VladaNedelceva/TSC---project/Hardware/Schematic.sch

## EAGLE design Hardware/Schematic.sch (2026-04-19)

Schematic: Schematic.sch

Parts:
ANT1: 2450AT18B100E_2450AT18B100E; 2450AT18B100E_ANTC3216X140N
C1, C26: 12pF; ESP32_C6_LIBRARY_1_ESP32_WROVER_EAGLE-LTSPICE_C0402
C1-EP-DR: 10uF; ESP32_C6_LIBRARY_1_ESP32_WROVER_EAGLE-LTSPICE_C0402
C2-EP-DR: 4.7uF/25V; ESP32_C6_LIBRARY_1_ESP32_WROVER_EAGLE-LTSPICE_C0402
C3, C4: 1pF; ESP32_C6_LIBRARY_1_ESP32_WROVER_EAGLE-LTSPICE_C0402
C5, C7, C8: 100nF; ESP32_C6_LIBRARY_1_ESP32_WROVER_EAGLE-LTSPICE_C0402
C6, C14: 4.7µF; ESP32_C6_LIBRARY_1_ESP32_WROVER_EAGLE-LTSPICE_C0402
C9: 820pF; ESP32_C6_LIBRARY_1_ESP32_WROVER_EAGLE-LTSPICE_C0402
C10, C22: N.C.; ESP32_C6_LIBRARY_1_ESP32_WROVER_EAGLE-LTSPICE_C0402
C11: 100pF; ESP32_C6_LIBRARY_1_ESP32_WROVER_EAGLE-LTSPICE_C0402
C12, C19: 100nF; PERFECT_0402_0402
C13: N.C.; PERFECT_0402_0402
C15: 1.0µF; PERFECT_0402_0402
C16: 47nF; PERFECT_0402_0402
C17, C18: 12pF; PERFECT_0402_0402
C20, C21: 4.7µF; PERFECT_0402_0402
C23: 0.1uF; ESP32_C6_LIBRARY_1_ESP32_WROVER_EAGLE-LTSPICE_C0402
C24: 10uF; GRM011R60J152KE01L_2_CAPC0201X13N
C25, C33: 22uF; ESP32_C6_LIBRARY_1_ESP32_WROVER_EAGLE-LTSPICE_C0402
C27, C34, C42: 0.1uF; GRM011R60J152KE01L_2_CAPC0201X13N
C29, C30, C31, C32: 1uF; GRM011R60J152KE01L_2_CAPC0201X13N
C37, C38: 1uF; GRM011R60J152KE01L_1_0201
C39: 10uF; PERFECT_0402_0402
C43: 4.7uF; ESP32_C6_LIBRARY_1_ESP32_WROVER_EAGLE-LTSPICE_C0402
D2, D4, D5: MBR0530; ESP32_C6_LIBRARY_5_SOD3716X135N
D3: USBLC6-2SC6Y; ESP32_C6_LIBRARY_3_SOT95P280X145-6N
EPD_C1, EPD_C2, EPD_C6, EPD_C7, EPD_C8, EPD_C9, EPD_C10, EPD_C11, EPD_C12: 1uF/50V; ESP32_C6_LIBRARY_1_ESP32_WROVER_EAGLE-LTSPICE_C0402
EPD_C5: 0.1uF/50V; ESP32_C6_LIBRARY_1_ESP32_WROVER_EAGLE-LTSPICE_C0402
IC1: BQ25180YBGR_BQ25180YBGR; BQ25180YBGR_BGA8C40P2X4_100X155X50
IC2: RT6160AWSC_RT6160AWSC; RT6160AWSC_BGA15C40P3X5_140X230X60
IC3: BMA421_BMA421
IC4: DRV2605YZFR_DRV2605YZFR; DRV2605YZFR_BGA9C50P3X3_144X144X62
J1: TC2030-IDC_TC2030-IDC; TC2030-IDC_TC2030IDC
J2: 503480-2400; 503480-2400_5034802400
J4: KH-TYPE-C-16P; KH-TYPE-C-16P_KINGHELM_KH-TYPE-C-16P
L1: 3.9nH; MLP2016SR47MT0S1_INDC2016X100N
L2: 10µH; MLP2016SR47MT0S1_INDC2016X100N
L3: 15nH; MLP2016SR47MT0S1_INDC2016X100N
L5: 68uH; MLP2016SR47MT0S1_INDC2016X100N
L7: MLP2016SR47MT0S1_FTC252012SR47MBCA; MLP2016SR47MT0S1_INDC2016X100N
Q1: 20V/4.2A/52mΩ/1.4W; ESP32_C6_LIBRARY_4_ESP32_C6_LIBRARY_4_ESP32_C6_LIBRARY_4_ES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
Q3: SI1308EDL-T1-GE3; ESP32_C6_LIBRARY_6_SOT65P210X110-3N
R1_EP_DR: 0.47; CPF0201D7K68C1_0201
R1_USB, R2_USB: 5K1; ERA-1AEB3401C_0201
R2, R3, R4: 0; CPF0201D7K68C1_0201
R2_EP_DR, R9: 10K; CPF0201D7K68C1_0201
R5, R7, R8: 10k; CPF0201D7K68C1_0201
R17, R18: 3K3; CPF0201D7K68C1_0201
R_PWR_EPD: 10K; CPF0201D7K68C1_0201
R_TYPE_SEL: 2.2; CPF0201D7K68C1_0201
SJ1: OPEN; ESP32_C6_LIBRARY_7_JUMPER_SJ
SW_DN: 2025-10-22_07-23-44_LIBRARY_EVP-AKE31ASW_EVP-AKE3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; 2025-10-22_07-23-44_LIBRARY_SW_EVP-AKE31A_PAN
SW_ENT: 2025-10-22_07-23-44_LIBRARY_EVP-AKE31ASW_EVP-AKE3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; 2025-10-22_07-23-44_LIBRARY_SW_EVP-AKE31A_PAN
SW_UP: 2025-10-22_07-23-44_LIBRARY_EVP-AKE31ASW_EVP-AKE3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; 2025-10-22_07-23-44_LIBRARY_SW_EVP-AKE31A_PAN
TP_3.3V, TP_3V3: HECTOR_WATCH_1_TPTP20R; HECTOR_WATCH_1_TP20R
TP_BAT_GND: HECTOR_WATCH_1_TPTP20R; HECTOR_WATCH_1_TP20R
TP_GND: HECTOR_WATCH_1_TPTP20R; HECTOR_WATCH_1_TP20R
TP_RESET: HECTOR_WATCH_1_TPTP20R; HECTOR_WATCH_1_TP20R
TP_SCL: HECTOR_WATCH_1_TPTP20R; HECTOR_WATCH_1_TP20R
TP_SDA: HECTOR_WATCH_1_TPTP20R; HECTOR_WATCH_1_TP20R
TP_SWDCLK: HECTOR_WATCH_1_TPTP20R; HECTOR_WATCH_1_TP20R
TP_SWDIO: HECTOR_WATCH_1_TPTP20R; HECTOR_WATCH_1_TP20R
TP_SWO: HECTOR_WATCH_1_TPTP20R; HECTOR_WATCH_1_TP20R
TP_VBAT: HECTOR_WATCH_1_TPTP20R; HECTOR_WATCH_1_TP20R
TP_VREG: HECTOR_WATCH_1_TPTP20R; HECTOR_WATCH_1_TP20R
U3: MAX17048G+T10; ESP32_C6_LIBRARY_SON50P200X200X80-9N
U$1: NORDIC_NRF_4_NRF52840_QF; NORDIC_NRF_4_AQFN50P700X700X85_HS-74N
X1: 32MHz; NORDIC_NRF_BT-XTAL_2016_N
X2: 32.768kHz; NORDIC_NRF_1_XTAL_3215_N

Connections:
3V3/1.7D: C34.2, IC4.C2 (VDD), Q1.2 (S), R5.2, R7.2, R8.2, R_PWR_EPD.2
3V3/2.4A: C6.1, C7.1, C8.1, C12.1, C14.1, C19.1, C25.1, C33.1, IC2.E2 (VOUT_1), IC2.E3 (VOUT_2), IC3.3 (VDDIO), IC3.7 (VDD), IC3.10 (CSB), J1.1, R17.1, R18.1, TP_3.3V.TP, TP_3V3.TP, U$1.P$A22 (VDD), U$1.P$AD14 (VDD), U$1.P$AD23 (VDD), U$1.P$B1 (VDD), U$1.P$W1 (VDD), U$1.P$Y2 (VDDH)
ALERT/1.6C: U3.5 (!ALERT)
ALERT/2.5C: U$1.P$J24 (P0.10/NFC2)
D+/1.5D: D3.4 (I/O2_2)
D+/2.7D: U$1.P$AD6 (D+)
D-/1.5D: D3.6 (I/O1_2)
D-/2.7D: U$1.P$AD4 (D-)
DEC4_6: C10.1, C15.1, C16.1, L3.2, U$1.P$B5 (DEC4), U$1.P$E24 (DEC6)
DN: D3.1 (I/O1_1), J4.A7 (DN1), J4.B7 (DN2)
DP: D3.3 (I/O2_1), J4.A6 (DP1), J4.B6 (DP2)
EPD_3V3: C1-EP-DR.1, EPD_C5.2, J2.15, J2.16, L5.1, Q1.3 (D)
EPD_BUSY/1.5D: J2.9
EPD_BUSY/2.2D: U$1.P$AD12 (P0.17)
EPD_CD/1.4C: J2.12
EPD_CS/2.2D: U$1.P$K2 (P0.05/AIN3)
EPD_DC/1.5D: J2.11
EPD_DC/2.2D: U$1.P$AD10 (P0.15)
EPD_RST/1.5D: J2.10
EPD_RST/2.2D: U$1.P$AC11 (P0.16)
GDR: J2.2, Q3.1 (G), R2_EP_DR.2
GND: C1.2, C1-EP-DR.2, C3.2, C4.2, C5.2, C6.2, C7.2, C8.2, C9.2, C10.2, C11.2, C12.2, C13.2, C14.2, C15.2, C16.2, C17.1, C18.1, C19.2, C20.2, C21.2, C22.2, C23.1, C24.2, C25.2, C26.2, C27.1, C29.1, C30.1, C31.1, C32.1, C33.2, C34.1, C37.1, C38.1, C39.2, C42.2, C43.2, D3.2 (GND), D4.1 (K), EPD_C1.1, EPD_C2.1, EPD_C5.1, EPD_C6.1, EPD_C7.1, EPD_C8.1, EPD_C9.1, EPD_C10.1, EPD_C11.1, EPD_C12.1, IC1.D2 (GND), IC2.B1 (VSEL), IC2.C1 (AGND), IC2.C2 (PGND_1), IC2.C3 (PGND_2), IC3.8 (GNDIO), IC3.9 (GND), IC4.B1 (IN/TRIG), IC4.B3 (GND), J1.3, J1.5, J2.8, J2.17, J2.MP1, J2.MP2, J4.A1_B12 (GND), J4.SH1 (SHIELD), R1_USB.1, R2_EP_DR.1, R2_USB.2, R3.2, R9.1, R_TYPE_SEL.1, SJ1.1, SW_DN.1, SW_ENT.1, SW_UP.1, TP_BAT_GND.TP, TP_GND.TP, U3.1 (CTG), U3.4 (GND), U3.6 (QSTRT), U3.9 (EP), U$1.P$74 (VSS_PAD), U$1.P$B7 (VSS), U$1.P$F23 (VSS_PA), X1.2, X1.4
HAPTIC_EN/1.4C: IC4.A1 (EN)
HAPTIC_EN/2.6A: U$1.P$U1 (P0.12)
IMU_INT1: IC3.5 (INT1), U$1.P$N1 (P0.08)
IMU_INT2: IC3.6 (INT2), U$1.P$P2 (P1.08)
LX1: IC2.B2 (SW1_1), IC2.B3 (SW1_2), L7.1
LX2: IC2.D2 (SW2_1), IC2.D3 (SW2_2), L7.2
MOSI/1.5B: J2.14
MOSI/2.2D: U$1.P$B13 (P0.03/AIN1)
unnamed: IC2.D1 (SCL), R4.1
unnamed: C3.1, L1.1, U$1.P$H23 (ANT)
unnamed: IC2.E1 (SDA), R2.1
unnamed: ANT1.1 (FEED), C4.1, C22.1, L1.2
unnamed: IC1.D1 (TS/MR), R9.2
unnamed: IC3.1 (SDO), R3.1
unnamed: C1.1, U$1.P$B24 (XC1), X1.1
unnamed: C26.1, U$1.P$A23 (XC2), X1.3
unnamed: C11.1, U$1.P$D23 (DEC3)
unnamed: C20.1, U$1.P$AC5 (DEC3V3)
unnamed: L2.1, U$1.P$B3 (DCC)
unnamed: L2.2, L3.1
unnamed: C13.1, U$1.P$A18 (DEC2)
unnamed: C9.1, U$1.P$N24 (DEC5)
unnamed: J4.A5 (CC1), R1_USB.2
unnamed: C32.2, IC4.A2 (REG)
unnamed: C5.1, U$1.P$C1 (DEC1)
unnamed: C17.2, U$1.P$D2 (P0.00/XL1), X2.1
unnamed: EPD_C1.2, J2.5
unnamed: C18.2, U$1.P$F2 (P0.01/XL2), X2.2
unnamed: J4.B5 (CC2), R2_USB.1
unnamed: EPD_C2.2, J2.4
unnamed: C2-EP-DR.2, D5.2 (A), L5.2, Q3.3 (D)
unnamed: EPD_C6.2, J2.18
unnamed: EPD_C7.2, J2.19
unnamed: EPD_C8.2, J2.20
unnamed: C2-EP-DR.1, D2.1 (K), D4.2 (A)
unnamed: EPD_C10.2, J2.22
unnamed: EPD_C12.2, J2.24
unnamed: R1_EP_DR.1, R_TYPE_SEL.2, SJ1.2
OUT+: IC4.A3 (OUT+)
OUT-: IC4.C3 (OUT-)
P0.04: U$1.P$J1 (P0.04/AIN2)
P0.09: U$1.P$L24 (P0.09/NFC1)
P0.13/1.5D: C30.2, R5.1, SW_UP.2
P0.13/2.6C: U$1.P$AD8 (P0.13)
P0.14/1.5D: C31.2, R8.1, SW_ENT.2
P0.14/2.7C: U$1.P$AC9 (P0.14)
P0.19: U$1.P$AC15 (P0.19)
P0.20: U$1.P$AD16 (P0.20)
P0.21: U$1.P$AC17 (P0.21)
P0.22: U$1.P$AD18 (P0.22)
P0.23: U$1.P$AC19 (P0.23)
P0.24: U$1.P$AD20 (P0.24)
P0.25: U$1.P$AC21 (P0.25)
P0.26: U$1.P$G1 (P0.26)
P0.27: U$1.P$H2 (P0.27)
P0.28: U$1.P$B11 (P0.28/AIN4)
P0.29: U$1.P$A10 (P0.29/AIN5)
P0.30: U$1.P$B9 (P0.30/AIN6)
P0.31: U$1.P$A8 (P0.31/AIN7)
P1.01/1.6C: Q1.1 (G), R_PWR_EPD.1
P1.01/2.4B: U$1.P$Y23 (P1.01)
P1.02/1.6C: C29.2, R7.1, SW_DN.2
P1.02/2.8C: U$1.P$W24 (P1.02)
P1.03: U$1.P$V23 (P1.03)
P1.04: U$1.P$U24 (P1.04)
P1.05: U$1.P$T23 (P1.05)
P1.06: U$1.P$R24 (P1.06)
P1.07: U$1.P$P23 (P1.07)
P1.09: U$1.P$R1 (P1.09)
P1.10: U$1.P$A20 (P1.10)
P1.11: U$1.P$B19 (P1.11)
P1.12: U$1.P$B17 (P1.12)
P1.13: U$1.P$A16 (P1.13)
P1.14: U$1.P$B15 (P1.14)
P1.15: U$1.P$A14 (P1.15)
PMIC_INT: IC1.A1 (!INT), U$1.P$T2 (P0.11)
PREVGH: D5.1 (K), EPD_C9.2, J2.21
PREVGL: D2.2 (A), EPD_C11.2, J2.23
RESE: J2.3, Q3.2 (S), R1_EP_DR.2
RESET: J1.6, TP_RESET.TP, U$1.P$AC13 (P0.18/RESET)
SCK/1.5B: J2.13
SCK/2.2D: U$1.P$A12 (P0.02/AIN0)
SCL/1.4C: IC4.C1 (SCL), U3.7 (SCL), U3.8 (SDA)
SCL/2.4C: IC1.B1 (SCL), IC3.12 (SCX), R4.2, R17.2, TP_SCL.TP, U$1.P$M2 (P0.07)
SDA/1.4C: IC4.B2 (SDA)
SDA/2.4C: IC1.C1 (SDA), IC3.2 (SDX), R2.2, R18.2, TP_SDA.TP, U$1.P$L1 (P0.06)
SWDCLK: J1.4, TP_SWDCLK.TP, U$1.P$AA24 (SWDCLK)
SWDIO: J1.2, TP_SWDIO.TP, U$1.P$AC24 (SWDIO)
SWO: TP_SWO.TP, U$1.P$AD22 (P1.00)
VBAT/1.2A: C27.2, TP_VBAT.TP, U3.2 (CELL), U3.3 (VDD)
VBAT/2.5C: C37.2, IC1.C2 (BAT)
VBUS/1.5D: C42.1, C43.1, D3.5 (VBUS), J4.A4_B9 (VBUS)
VBUS/2.6D: C21.1, C38.2, IC1.A2 (IN), U$1.P$AD2 (VBUS)
VREG: C23.2, C24.1, C39.1, IC1.B2 (SYS), IC2.A1 (EN), IC2.A2 (VIN_1), IC2.A3 (VIN_2), TP_VREG.TP
