VladaNedelceva/TSC---project/(commit log)

2026-04-10 Schematic.sch added
    [Schematic.sch]
2026-04-19 schematic upate
    [Schematic.sch]
