VladaNedelceva/TSC---project/(notices)

Notices in the files:
parts and their libraries:
InkTime_v5: COPYRIGHT: Copyright (C) 2025 Ultra Librarian. All rights reserved.
